WLLEGit/VerilogCPU-CKernel/hardware/riscv_hardware.htm

# DE10 Standard Configuration

## Pin Assignments:

- CLOCK
- KEY
- SW
- LED
- Seg7
- VGA
- PS2

## Pin Assignment Table:

CLOCK
Name | Location | Direction | Standard
CLOCK2_50 | AA16 | input | 3.3-V LVTTL
CLOCK3_50 | Y26 | input | 2.5 V
CLOCK4_50 | K14 | input | 3.3-V LVTTL
CLOCK_50 | AF14 | input | 3.3-V LVTTL

KEY
Name | Location | Direction | Standard
KEY[0] | AJ4 | input | 3.3-V LVTTL
KEY[1] | AK4 | input | 3.3-V LVTTL
KEY[2] | AA14 | input | 3.3-V LVTTL
KEY[3] | AA15 | input | 3.3-V LVTTL

SW
Name | Location | Direction | Standard
SW[0] | AB30 | input | 2.5 V
SW[1] | Y27 | input | 2.5 V
SW[2] | AB28 | input | 2.5 V
SW[3] | AC30 | input | 2.5 V
SW[4] | W25 | input | 2.5 V
SW[5] | V25 | input | 2.5 V
SW[6] | AC28 | input | 2.5 V
SW[7] | AD30 | input | 2.5 V
SW[8] | AC29 | input | 2.5 V
SW[9] | AA30 | input | 2.5 V

LED
Name | Location | Direction | Standard
LEDR[0] | AA24 | output | 3.3-V LVTTL
LEDR[1] | AB23 | output | 3.3-V LVTTL
LEDR[2] | AC23 | output | 3.3-V LVTTL
LEDR[3] | AD24 | output | 3.3-V LVTTL
LEDR[4] | AG25 | output | 3.3-V LVTTL
LEDR[5] | AF25 | output | 3.3-V LVTTL
LEDR[6] | AE24 | output | 3.3-V LVTTL
LEDR[7] | AF24 | output | 3.3-V LVTTL
LEDR[8] | AB22 | output | 3.3-V LVTTL
LEDR[9] | AC22 | output | 3.3-V LVTTL

Seg7
Name | Location | Direction | Standard
HEX0[0] | W17 | output | 3.3-V LVTTL
HEX0[1] | V18 | output | 3.3-V LVTTL
HEX0[2] | AG17 | output | 3.3-V LVTTL
HEX0[3] | AG16 | output | 3.3-V LVTTL
HEX0[4] | AH17 | output | 3.3-V LVTTL
HEX0[5] | AG18 | output | 3.3-V LVTTL
HEX0[6] | AH18 | output | 3.3-V LVTTL
HEX1[0] | AF16 | output | 3.3-V LVTTL
HEX1[1] | V16 | output | 3.3-V LVTTL
HEX1[2] | AE16 | output | 3.3-V LVTTL
HEX1[3] | AD17 | output | 3.3-V LVTTL
HEX1[4] | AE18 | output | 3.3-V LVTTL
HEX1[5] | AE17 | output | 3.3-V LVTTL
HEX1[6] | V17 | output | 3.3-V LVTTL
HEX2[0] | AA21 | output | 3.3-V LVTTL
HEX2[1] | AB17 | output | 3.3-V LVTTL
HEX2[2] | AA18 | output | 3.3-V LVTTL
HEX2[3] | Y17 | output | 3.3-V LVTTL
HEX2[4] | Y18 | output | 3.3-V LVTTL
HEX2[5] | AF18 | output | 3.3-V LVTTL
HEX2[6] | W16 | output | 3.3-V LVTTL
HEX3[0] | Y19 | output | 3.3-V LVTTL
HEX3[1] | W19 | output | 3.3-V LVTTL
HEX3[2] | AD19 | output | 3.3-V LVTTL
HEX3[3] | AA20 | output | 3.3-V LVTTL
HEX3[4] | AC20 | output | 3.3-V LVTTL
HEX3[5] | AA19 | output | 3.3-V LVTTL
HEX3[6] | AD20 | output | 3.3-V LVTTL
HEX4[0] | AD21 | output | 3.3-V LVTTL
HEX4[1] | AG22 | output | 3.3-V LVTTL
HEX4[2] | AE22 | output | 3.3-V LVTTL
HEX4[3] | AE23 | output | 3.3-V LVTTL
HEX4[4] | AG23 | output | 3.3-V LVTTL
HEX4[5] | AF23 | output | 3.3-V LVTTL
HEX4[6] | AH22 | output | 3.3-V LVTTL
HEX5[0] | AF21 | output | 3.3-V LVTTL
HEX5[1] | AG21 | output | 3.3-V LVTTL
HEX5[2] | AF20 | output | 3.3-V LVTTL
HEX5[3] | AG20 | output | 3.3-V LVTTL
HEX5[4] | AE19 | output | 3.3-V LVTTL
HEX5[5] | AF19 | output | 3.3-V LVTTL
HEX5[6] | AB21 | output | 3.3-V LVTTL

VGA
Name | Location | Direction | Standard
VGA_BLANK_N | AK22 | output | 3.3-V LVTTL
VGA_B[0] | AJ21 | output | 3.3-V LVTTL
VGA_B[1] | AJ20 | output | 3.3-V LVTTL
VGA_B[2] | AH20 | output | 3.3-V LVTTL
VGA_B[3] | AJ19 | output | 3.3-V LVTTL
VGA_B[4] | AH19 | output | 3.3-V LVTTL
VGA_B[5] | AJ17 | output | 3.3-V LVTTL
VGA_B[6] | AJ16 | output | 3.3-V LVTTL
VGA_B[7] | AK16 | output | 3.3-V LVTTL
VGA_CLK | AK21 | output | 3.3-V LVTTL
VGA_G[0] | AK26 | output | 3.3-V LVTTL
VGA_G[1] | AJ25 | output | 3.3-V LVTTL
VGA_G[2] | AH25 | output | 3.3-V LVTTL
VGA_G[3] | AK24 | output | 3.3-V LVTTL
VGA_G[4] | AJ24 | output | 3.3-V LVTTL
VGA_G[5] | AH24 | output | 3.3-V LVTTL
VGA_G[6] | AK23 | output | 3.3-V LVTTL
VGA_G[7] | AH23 | output | 3.3-V LVTTL
VGA_HS | AK19 | output | 3.3-V LVTTL
VGA_R[0] | AK29 | output | 3.3-V LVTTL
VGA_R[1] | AK28 | output | 3.3-V LVTTL
VGA_R[2] | AK27 | output | 3.3-V LVTTL
VGA_R[3] | AJ27 | output | 3.3-V LVTTL
VGA_R[4] | AH27 | output | 3.3-V LVTTL
VGA_R[5] | AF26 | output | 3.3-V LVTTL
VGA_R[6] | AG26 | output | 3.3-V LVTTL
VGA_R[7] | AJ26 | output | 3.3-V LVTTL
VGA_SYNC_N | AJ22 | output | 3.3-V LVTTL
VGA_VS | AK18 | output | 3.3-V LVTTL

PS2
Name | Location | Direction | Standard
PS2_CLK | AB25 | inout | 3.3-V LVTTL
PS2_CLK2 | AC25 | inout | 3.3-V LVTTL
PS2_DAT | AA25 | inout | 3.3-V LVTTL
PS2_DAT2 | AB26 | inout | 3.3-V LVTTL
