WLLEGit/VerilogCPU-CKernel/report/pics/load-use2.png

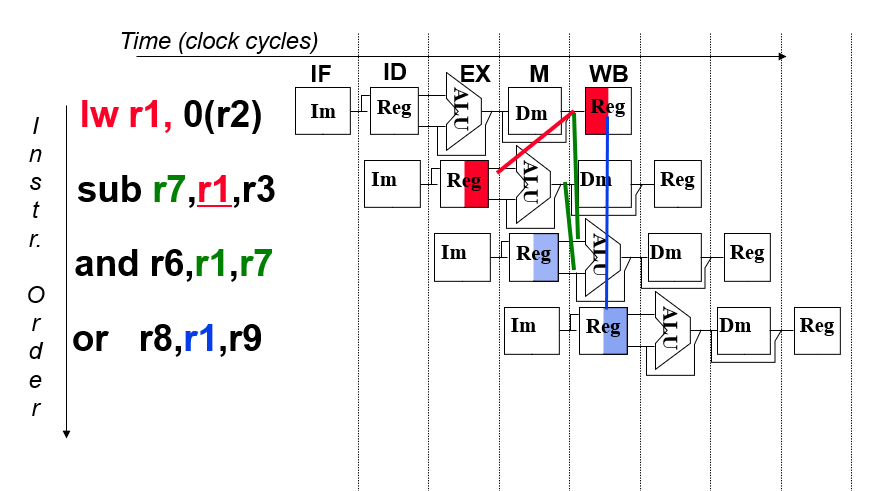
report/pics/load-use2.png
