WLLEGit/VerilogCPU-CKernel/hardware/vga/process_haddr.v

module process_haddr (
    input [9:0]haddr,
    output reg [6:0] x,
    output reg [3:0] remain
);
    
always @(haddr) begin
case(haddr) 
10'd1: begin
	x<=7'd0; remain<=4'd0;
end 10'd2: begin
	x<=7'd0; remain<=4'd1;
end 10'd3: begin
	x<=7'd0; remain<=4'd2;
end 10'd4: begin
	x<=7'd0; remain<=4'd3;
end 10'd5: begin
	x<=7'd0; remain<=4'd4;
end 10'd6: begin
	x<=7'd0; remain<=4'd5;
end 10'd7: begin
	x<=7'd0; remain<=4'd6;
end 10'd8: begin
	x<=7'd0; remain<=4'd7;
end 10'd9: begin
	x<=7'd0; remain<=4'd8;
end 10'd10: begin
	x<=7'd1; remain<=4'd0;
end 10'd11: begin
	x<=7'd1; remain<=4'd1;
end 10'd12: begin
	x<=7'd1; remain<=4'd2;
end 10'd13: begin
	x<=7'd1; remain<=4'd3;
end 10'd14: begin
	x<=7'd1; remain<=4'd4;
end 10'd15: begin
	x<=7'd1; remain<=4'd5;
end 10'd16: begin
	x<=7'd1; remain<=4'd6;
end 10'd17: begin
	x<=7'd1; remain<=4'd7;
end 10'd18: begin
	x<=7'd1; remain<=4'd8;
end 10'd19: begin
	x<=7'd2; remain<=4'd0;
end 10'd20: begin
	x<=7'd2; remain<=4'd1;
end 10'd21: begin
	x<=7'd2; remain<=4'd2;
end 10'd22: begin
	x<=7'd2; remain<=4'd3;
end 10'd23: begin
	x<=7'd2; remain<=4'd4;
end 10'd24: begin
	x<=7'd2; remain<=4'd5;
end 10'd25: begin
	x<=7'd2; remain<=4'd6;
end 10'd26: begin
	x<=7'd2; remain<=4'd7;
end 10'd27: begin
	x<=7'd2; remain<=4'd8;
end 10'd28: begin
	x<=7'd3; remain<=4'd0;
end 10'd29: begin
	x<=7'd3; remain<=4'd1;
end 10'd30: begin
	x<=7'd3; remain<=4'd2;
end 10'd31: begin
	x<=7'd3; remain<=4'd3;
end 10'd32: begin
	x<=7'd3; remain<=4'd4;
end 10'd33: begin
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
	x<=7'd67; remain<=4'd3;
end 10'd608: begin
	x<=7'd67; remain<=4'd4;
end 10'd609: begin
	x<=7'd67; remain<=4'd5;
end 10'd610: begin
	x<=7'd67; remain<=4'd6;
end 10'd611: begin
	x<=7'd67; remain<=4'd7;
end 10'd612: begin
	x<=7'd67; remain<=4'd8;
end 10'd613: begin
	x<=7'd68; remain<=4'd0;
end 10'd614: begin
	x<=7'd68; remain<=4'd1;
end 10'd615: begin
	x<=7'd68; remain<=4'd2;
end 10'd616: begin
	x<=7'd68; remain<=4'd3;
end 10'd617: begin
	x<=7'd68; remain<=4'd4;
end 10'd618: begin
	x<=7'd68; remain<=4'd5;
end 10'd619: begin
	x<=7'd68; remain<=4'd6;
end 10'd620: begin
	x<=7'd68; remain<=4'd7;
end 10'd621: begin
	x<=7'd68; remain<=4'd8;
end 10'd622: begin
	x<=7'd69; remain<=4'd0;
end 10'd623: begin
	x<=7'd69; remain<=4'd1;
end 10'd624: begin
	x<=7'd69; remain<=4'd2;
end 10'd625: begin
	x<=7'd69; remain<=4'd3;
end 10'd626: begin
	x<=7'd69; remain<=4'd4;
end 10'd627: begin
	x<=7'd69; remain<=4'd5;
end 10'd628: begin
	x<=7'd69; remain<=4'd6;
end 10'd629: begin
	x<=7'd69; remain<=4'd7;
end 10'd630: begin
	x<=7'd69; remain<=4'd8;
end default: begin x<=7'd0; remain<=4'd0; end
endcase
end

endmodule
