WLLEGit/VerilogCPU-CKernel/hardware/vga/process_vaddr.v

module process_vaddr (
    input [9:0]vaddr,
    output reg [4:0] y,
    output reg [3:0] remain
);
    
always @(vaddr) begin
case(vaddr) 
10'd1: begin
	y<=5'd0; remain<=4'd0;
end 10'd2: begin
	y<=5'd0; remain<=4'd1;
end 10'd3: begin
	y<=5'd0; remain<=4'd2;
end 10'd4: begin
	y<=5'd0; remain<=4'd3;
end 10'd5: begin
	y<=5'd0; remain<=4'd4;
end 10'd6: begin
	y<=5'd0; remain<=4'd5;
end 10'd7: begin
	y<=5'd0; remain<=4'd6;
end 10'd8: begin
	y<=5'd0; remain<=4'd7;
end 10'd9: begin
	y<=5'd0; remain<=4'd8;
end 10'd10: begin
	y<=5'd0; remain<=4'd9;
end 10'd11: begin
	y<=5'd0; remain<=4'd10;
end 10'd12: begin
	y<=5'd0; remain<=4'd11;
end 10'd13: begin
	y<=5'd0; remain<=4'd12;
end 10'd14: begin
	y<=5'd0; remain<=4'd13;
end 10'd15: begin
	y<=5'd0; remain<=4'd14;
end 10'd16: begin
	y<=5'd0; remain<=4'd15;
end 10'd17: begin
	y<=5'd1; remain<=4'd0;
end 10'd18: begin
	y<=5'd1; remain<=4'd1;
end 10'd19: begin
	y<=5'd1; remain<=4'd2;
end 10'd20: begin
	y<=5'd1; remain<=4'd3;
end 10'd21: begin
	y<=5'd1; remain<=4'd4;
end 10'd22: begin
	y<=5'd1; remain<=4'd5;
end 10'd23: begin
	y<=5'd1; remain<=4'd6;
end 10'd24: begin
	y<=5'd1; remain<=4'd7;
end 10'd25: begin
	y<=5'd1; remain<=4'd8;
end 10'd26: begin
	y<=5'd1; remain<=4'd9;
end 10'd27: begin
	y<=5'd1; remain<=4'd10;
end 10'd28: begin
	y<=5'd1; remain<=4'd11;
end 10'd29: begin
	y<=5'd1; remain<=4'd12;
end 10'd30: begin
	y<=5'd1; remain<=4'd13;
end 10'd31: begin
	y<=5'd1; remain<=4'd14;
end 10'd32: begin
	y<=5'd1; remain<=4'd15;
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
	y<=5'd29; remain<=4'd4;
end 10'd470: begin
	y<=5'd29; remain<=4'd5;
end 10'd471: begin
	y<=5'd29; remain<=4'd6;
end 10'd472: begin
	y<=5'd29; remain<=4'd7;
end 10'd473: begin
	y<=5'd29; remain<=4'd8;
end 10'd474: begin
	y<=5'd29; remain<=4'd9;
end 10'd475: begin
	y<=5'd29; remain<=4'd10;
end 10'd476: begin
	y<=5'd29; remain<=4'd11;
end 10'd477: begin
	y<=5'd29; remain<=4'd12;
end 10'd478: begin
	y<=5'd29; remain<=4'd13;
end 10'd479: begin
	y<=5'd29; remain<=4'd14;
end 10'd480: begin
	y<=5'd29; remain<=4'd15;
end default: begin y<=5'd0; remain<=4'd0; end
endcase
end
endmodule
