WLLEGit/VerilogCPU-CKernel/kernel/include/global.h

#ifndef _GLOBAL_H
#define _GLOBAL_H

// #define DEBUG
#define inline __attribute((always_inline))  // able to play the chardance, but may cause some problems
// #define inline 

#define INSTR_OFFSET        0x00000000 
#define DATA_OFFSET         0x00100000
#define VGA_INFO_OFFSET     0x00200000
#define VGA_CHAR_OFFSET     0x00300000
#define VGA_COLOR_OFFSET    0x00400000
#define KB_INFO_OFFSET      0x00500000
#define TMP_STACK_OFFSET    0x00700000
#define OUTPUT_PIN_OFFSET   0x00800000
#define SEG7_OFFSET  	    0x00810000
#define LEDR_OFFSET         0x00820000
#define VIDEO_OFFSET        0x00900000

#define VGA_WIDTH 640
#define VGA_HEIGHT 480

#define ROW_CNT 30
#define COL_CNT 64
#define TOTAL_CHAR (ROW_CNT * COL_CNT)
#define TOTAL_CHAR_WITH_BUF (64 * 64)
#define VGA_BUFFER_ROW 64

#define CHAR_WIDTH 9
#define CHAR_HEIGHT 16

// CSRs internal index
#define MSTATUS 0x300
#define MTVEC 0x305
#define MSCRATCH 0x340
#define MEPC 0x341
#define MCAUSE 0x342
#define CYCLE 0xc00
#define CYCLEH 0xc80

typedef unsigned char uint8_t;      /* Unsigned 8 bit quantity  */
typedef signed char int8_t;         /* Signed 8 bit quantity    */
typedef unsigned short uint16_t;    /* Unsigned 16 bit quantity */
typedef signed short int16_t;       /* Signed 16 bit quantity   */
typedef unsigned int uint32_t;      /* Unsigned 32 bit quantity */
typedef signed int int32_t;         /* Signed 32 bit quantity   */

#define bool uint8_t
#define true 1
#define false 0
#define NULL 0

#define KEY_REPEAT_INTERVAL 500  // input interval if one key keep pressed

enum{COLOR_RED, COLOR_GREEN, COLOR_BLUE, 
        COLOR_BLACK, COLOR_WHITE,};

extern uint8_t * const ch_mem;
extern uint8_t * const color_mem;
extern volatile uint32_t sys_time;

#define CLOCK_INT_MCAUSE  0x80000007
#define ECALL_MCAUSE  0x0000000b

#define CMD_MODE 0
#define VIDEO_MODE 1

#endif
