WLLEGit/VerilogCPU-CKernel/(commit log)

2021-11-28 fix connection bugs, add simulation files
    [pipeline.v]
2021-11-28 add pipeline flush, fix some bugs
    [contrgen.v, cpu_ctrl.v, pipeline.v, riscv_hardware.v]
2021-11-29 fix some bugs, memory bugs to solve
    [cpu_ctrl.v, pipeline.v]
2021-11-29 fix some bugs, sw bug remains
    [cpu_ctrl.v, define.v, pipeline.v]
2021-11-29 pipeline seem ready, despite testcase:sh 0x80002a3c interesing bug
    [pipeline.v]
2021-11-30 check cpu after adding interrupt
2021-11-30 syntax errors solved, compilation pass
    [c5_pin_model_dump.txt]
2021-11-30 add tmp_stack for interrupt
2021-12-01 fix bugs in instr rom
    [main.c, memory_map.v, pipeline.v, riscv_hardware.v]
2021-12-01 fix some bugs of intr
    [client.v, contrgen.v, cpu_ctrl.v, kb_driver.v, pipeline.v, timer.v]
2021-12-02 fix bugs in csr contr gen
    [client.v, contrgen.v, memory_map.v, pipeline.v, riscv_hardware.v, syscall.c]
2021-12-03 fix bugs in div/mod and itoa
    [global.h, main.c, memory_map.v, riscv_hardware.v, stdfuncs.c, syscall.c]
2021-12-03 Kernel launch succed, IO seem correct
    [global.h, io_mm.c, io_mm.h, irq.c, main.c, memory_map.v, riscv_hardware.v, syscall.c]
2021-12-07 fix bugs in strtok, ready for use
    [stdfuncs.c, stdfuncs.h, ui.c]
2021-12-10 Fix bugs in scroll_screen, add video support
    [global.h, syscall.c, syscall.h, ui.c]
2021-12-10 fix bugs in scroll screen
    [global.h, memory_map.v, syscall.c, ui.c]
2021-12-10 strange bug in chardance
    [ui.c]
2021-12-12 chardance play with bug
    [global.h, syscall.c, ui.c]
